alexsnarli/DigitalCamera/README.md

# DigitalCamera

Semester project in the subject TFE4152 - Design of Integrated Ciruits.

Design and simulation of a four pixel digital camera. Simulated analog circuit using AIM-Spice and the digital circuit using Verilog.

My partner and I scored top in our class on the report.
