alexsnarli/DigitalCamera/IC_Prosjekt.pdf

# Four Pixel Digital Camera

## TFE4152 – Design of Integrated Circuits

## Alexander Rambøl Snarli & Andrea Catharina Worsøe

Group 26

## November 18, 2019

## Faculty of Information Technology and Electrical Engineering Norwegian University of Science and Technology

Abstract

This design report describes the design of the integrated circuits needed for a four pixel digital camera. Both the digital and analog part of the circuit is described and simulated. The digital circuit is created using the hardware descriptive language Verilog, and simulated using the program Active-HDL. The analog part of the circuit it simulated using the program AIM-Spice. This report also describes the process of choosing the right dimensions for both NMOS and PMOS transistors using 180nm transistor technology, and choosing the right capacitors for the circuit. Both the digital and analog circuit has been tested in the simulations, to make sure the system behaves as intended. The simulations and tests shows that both the digital and analog circuits behave as inteded, and that the system operates as a four pixel digital camera successfully.

## Contents

1 Introduction | 3
2 Theoretical Background | 3
3 Design | 11
4 Simulations | 15
5 Results and Discussion | 23
6 Conclusion | 23

2

A Verilog Listing | 25
B AIM-Spice Listing | 31

## 1 Introduction

While film photography might be very trendy, digital cameras are far more common today. A regular cellphone camera has maybe 12 megapixels, and can be made very small. These are quite complex digital systems. They consist of millions of sensors, which are analog, that sample the light and store it digitally. To illustrate how this works one can design a smaller camera, in this case of four pixels.

Figure 1 shows a block diagram of a four pixel digital camera. Inside Readout and Control, there are three blocks. The block Pulse_shaper will not be discussed in this report. The other two blocks, RE_Control and Pixel_electronics, represent the digital and analog circuits respectively. This report describes both of these systems. The digital circuit receives input from the user, and send signals to the analog circuit based on the input. The analog part acts accordingly to the signals received from the digital circuit. The analog circuit output signals to an analog to digital converter, called an ADC. The ADC will not be discussed in this report. RE_Control will be simulated in Active-HDL, using the hardware descriptive language Verilog to build the circuit. Pixel_electronics represent the analog part of the circuit, and will be simulated using AIM-Spice. The analog part of the circuit is based on 180 nm CMOS technology, where transistors are used as switches and to create a buffer circuit. This report will also describe how to choose the right dimensions for the transistors and the capacitor in the analog circuit.

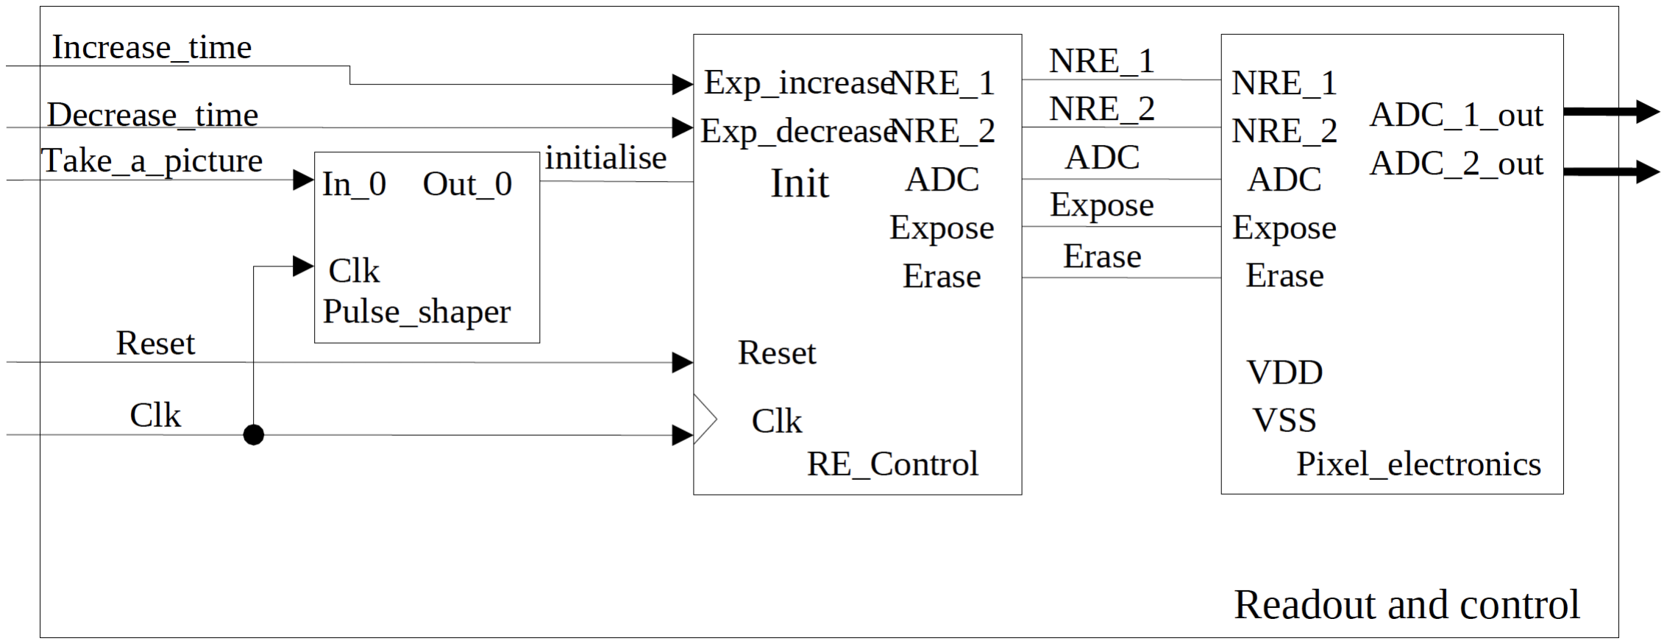
[picture p1: figure]

Figure 1: Block diagram of a four pixel digital camera. [1]

## 2 Theoretical Background

### 2.1 Digital Circuit Theory

The digital part of the circuit, RE_Control, receives input from the user, and control the analog circuit using these inputs. Figure 2 show the module for the digital circuit, with input signals on the left side and output signals on the right side of the module. init is the trigger signal, and is logically high when the user wants to take a photo. exp_inc and exp_dec will

3

be logically high, to increase and decrease the exposure time respectively, if the user wants to adjust the exposure time. Clk and Reset is controlled by control logic which will not be discussed in this paper. Reset will be logically high if the camera should be reset, and Clk is the clock signal for the circuit. The outputs NRE_1 and NRE_2 control which pixels should be read, while the ADC controls when the analog to digital converter should be initialized. Expose controls when the analog circuit should be exposed to light, and Erase erases the last exposure and resets the analog circuit.

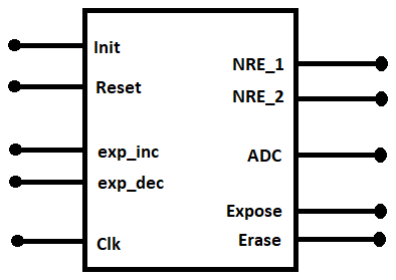
[picture p2: figure]

Figure 2: The digital circuit with inputs and outputs.

RE_Control, as seen in figure 3, consists of three modules called CTRL_ex_time, Timer_counter and FSM_ex_control. These are the exposure time controller, exposure time counter and finite state machine respectively.

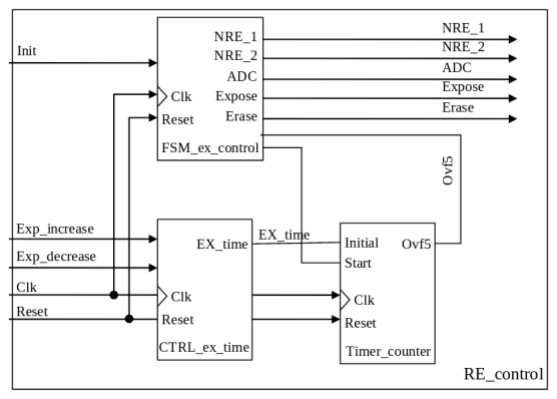
[picture p3: figure]

Figure 3: Block diagram of the digital circuit. [1]

4

### 2.1.1 Exposure Time Controller

The exposure time controller calculates the exposure time for the camera. The module has two user inputs, exp_inc and exp_dec. These inputs will increase or decrease the exposure time respectively. The user might want to adjust the exposure time based on the lighting conditions, which can affect the photographs quality. The exposure time is set to a base value, and increments or decrements a set value each time the user adjusts the exposure time. Exposure time also has an upper and a lower time boundary, and this module has to make sure exposure time stays within these boundaries. The exposure time controller sends the exposure time, EX_time, to the exposure time counter when the exposure time is calculated.

### 2.1.2 Exposure Time Counter

The exposure time counter controls the exposure time. The module receives the desired exposure time from the exposure time controller, and starts the counter when it receives the start signal, Start, from the finite state machine. When the exposure time is over, the overflow signal, Ovf5, will be sent back to the finite state machine.

### 2.1.3 Finite State Machine

The finite state machine is the most complex part of the digital circuit. A finite state machine, FSM, is a machine that has a set amount of states, which all have different characteristic values and functions. The FSM can only be in one of the states at any given time. The amount of states needed depends on the complexity of the system. The FSM will receive a trigger signal init which will start off the process of taking a picture. The start signal will be sent to the exposure timer counter, and it will receive the overflow signal when the exposure time is over. All the output signals from RE_Control to the analog circuit, are sent out through the finite state machine.

### 2.2 Analog Circuit Theory

The analog circuit is based on four identical circuits, which will output one pixel each. The circuit for each pixel is shown in figure 4.

5

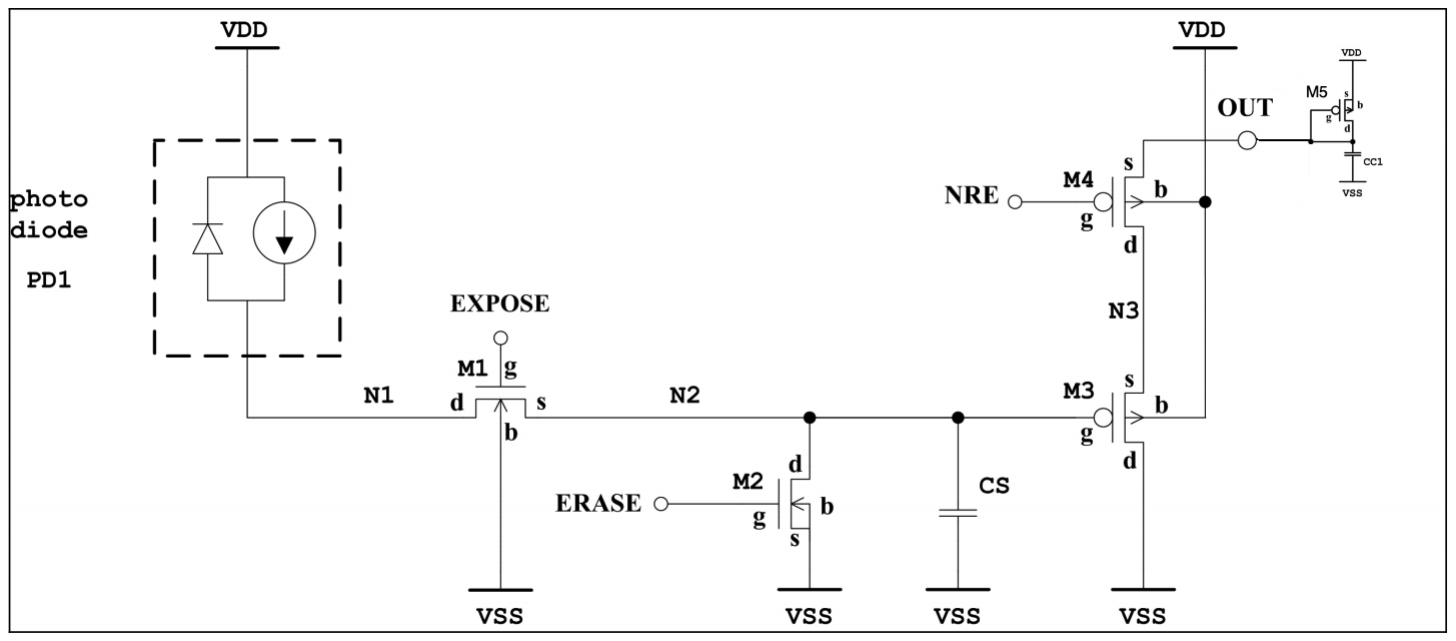
[picture p4: figure]

Figure 4: The analog circuit with the inputs Erase, Expose and NRE from the digital circuit. [1]

The circuit is based on a photo-diode, which will generate current. The generated current will depend on the lighting conditions, so that brighter conditions create a higher current and darker conditions create a lower current. This current is used to charge a capacitor, CS. Since we are charging a capacitor, we can achieve the same charge by exposing small current over a longer time interval, as exposing a higher current for a shorter time interval. Transistors M1 and M2 are NMOS transistors, and are controlled by logic signals from the digital circuit. While Expose is logic high, the capacitor CS is being charged. While Erase is logically high, we discharge the capacitor, and erase our last exposure so that we are ready to charge the capacitor again. In figure 4 you can also see the active load transistors MC1 and MC2 and its corresponding capacitors.

The circuit in figure 4 has nodes N1, N2 and N3 labeled. When the diode, P D1, is exposed to light and the Expose signal is set high the current IP D1 from the diode will continue to node N2. As long at the Erase signal is low, it will continue on to N3. The ADC can only read two pixels at a time, so the NRE signal decides whether the ADC is ready to read the signal or not. This is seen in figure 5.

The most important design decisions in this circuit are the dimensions of the transistors and the sizes of the capacitors. The design specifications are given in 3.2.

### 2.2.1 Choosing the Capacitors

The effective voltage of a transistor is given by equation (1).

Vef f = VGS − V t | (1)

Vef f should be above 100mV, and it is a good rule to keep it above 200 mV [3]. Since VGS = VG −VS this can be used to find the voltage over the capacitor, VS, as shown in section 3.2.

6

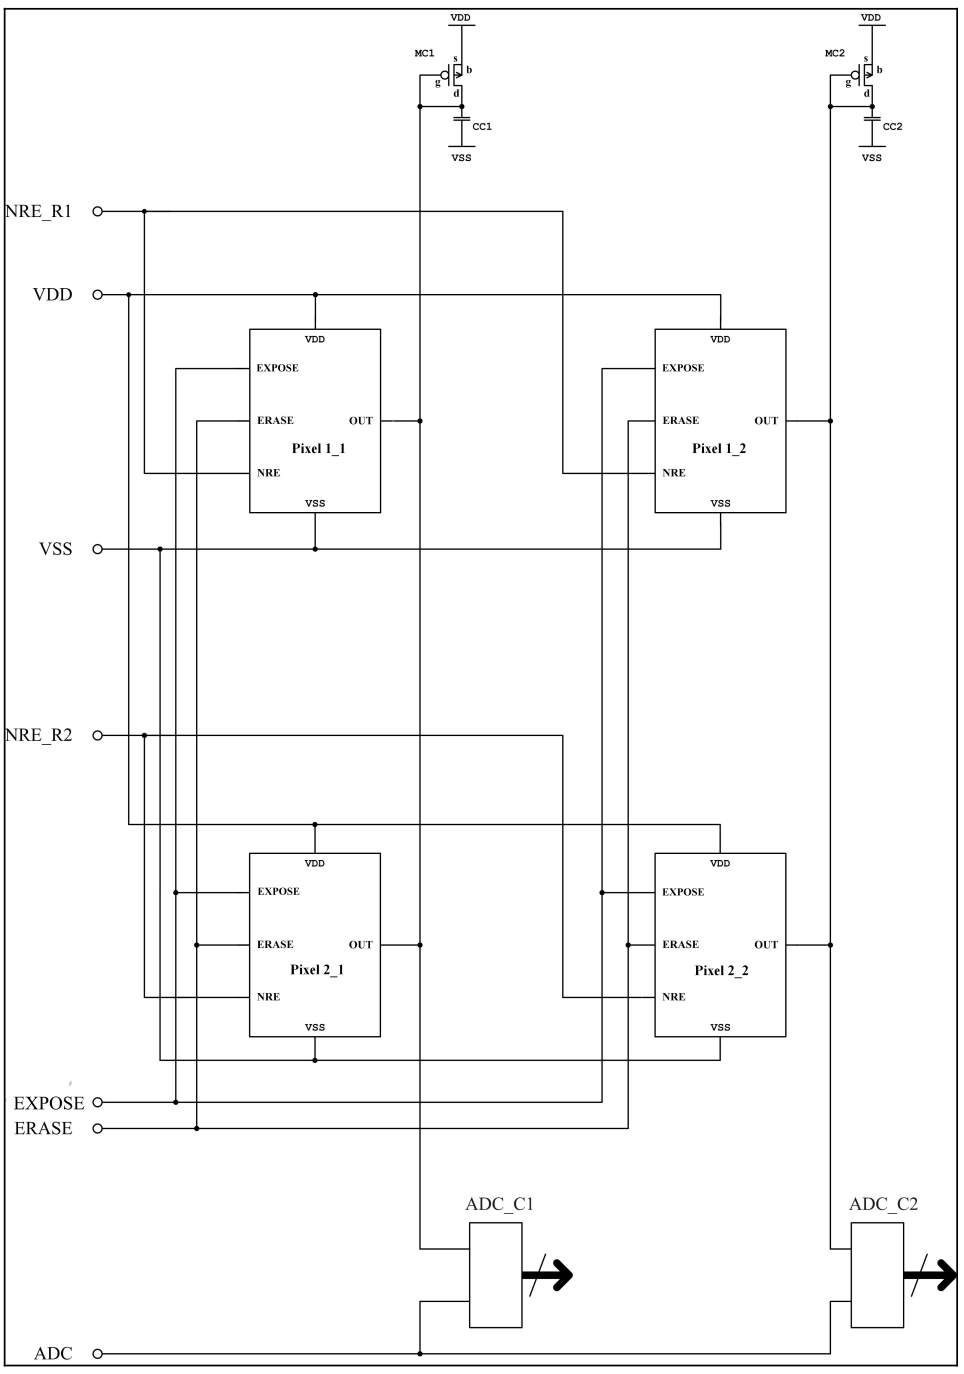
[picture p5: figure]

Figure 5: Four pixel array consisting of one pixel circuits, ADC_C1, ADC_C2 and active load transistor [1].

7

Due to the body-effect[3], which is caused by different voltages between source and bulk, we have to consider some more factors when doing calculations. For instance the voltage Vt is
given by equation (2).

Vt = Vt0 + γ(

q

VSB + |2ΦF | − q
|2ΦF |) | (2)

Equation (2) illustrates that the threshold voltage will be slightly higher with the body effect. The various components of this equations are given in equation (3) and equation (4).

ΦF =

kT
q

lnNA
ni

(3)

γ =

√
2qNAKSi0

Cox

(4)

The other are constants found in table 4 and 5. VSB is the voltage between source and bulk.

C =

It
V

(5)

The version of Ohm’s law, seen in equation (5), can be used to find the appropriate size for the capacitor Cs, using Vs as the voltage of the capacitor.

The other capacitors are given in the specifications, which can be found in section 3.2.

### 2.2.2 Choosing Dimensions for the Transistors

The equation for active region drain current is seen in equation (6) for NMOS and equation
(7) for PMOS [3].

ID =

1
2

µnCox

W
L

(Vtn − VGS)

2
[1 + λ(Vef f − VDS)] | (6)

ID =

1
2

µpCox

W
L

(VGS − Vtn)

2
[1 + λ(VDS − Vef f )] | (7)

The resistance between drain and source, rds can be related to to the drain current, ID, by
(8) [3].

rds ≈

1
λID

(8)

Here we use λ given by (9) for NMOS and (10) for PMOS [3]. Φ0 is the built in voltage of the junction.

8

λ =

1
L

p
VDS − Vef f + Φ0

(9)

λ =

1
L

p
Vef f − VDS + Φ0

(10)

Which again gives relation (11).

ID ∝

W
L

(11)

The transistors M1, M2 and M4 work as switches activated by specific signals from the digital circuit.

The buffer should be designed so that the gain is as close to 1 as possible. The important transistors here are M3 and MC. Here, the transistor MC is used as an active load. The transistor M4 is no concern, since it will work as a switch: either it has very low resistance, like a wire, or it has a very very high resistance, like an open circuit.

To find the gain, A, small signal analysis can be applied. The small signal model with body effect is shown in figure 6 [2].

To combine the current sources use that gm3Vsg +gm3Vbs = gm3(Vs −Vg +Vb −Vs) = gm3(Vb − Vg) = gm3Vbg. See also from the figure that by Kirchoff’s voltage law: Vbg = Vsg.

Vg

Vsg

Vs

Vout

gm3Vsg | gmbVbs

Vd

rds3

Vb

Vg

Figure 6: Small signal model for low frequencies. [2]

9

If one chooses to ignore the body effect, in the case that it is sufficiently small, this can be simplified. Figure 7 shows a simplified version of the model, along with the model for M5 simplified to a resistance. Because this is an active load common gate amplifier, we can simplify the impedance seen at Vout at low frequencies to ≈

1
gmC

[3, p. 126].

Vg

Vsg

Vs

Vout

gm3Vbg

VD

rds

1
gmC

Figure 7: Small signal model for M3 and MC with a combined current source.

Knowing that Vsg = Vbg, this is used in further calculations. The output is Vs and given by equation (12).

Vout = −Vsg(rds|| 1

gmC

) | (12)

Looking at the model, it also appears that Vg is the same as Vin. Vsg is given by equation (13).

Vsg = Vs − Vg = Vout − Vin | (13)

The resistance can be assumed to be rsd >> 1
gmC

[2], which allows for the equation (14).

Vout = −(Vout − Vin)gm3

1

gmc

(14)

The gain with simplifications is then given by equation (15).

10

A =

Vout

Vin

=

gm3

1
gmC
1 + gm3

1
gmC
=

gm3

gm3 + gmC

(15)

The value gm is given by equation (16) [3].

gm =

s
µCoxID

W
L

(16)

This formula is the same regardless of which gm one is looking at, and since all parameters are the same for both transistors the gain can be simplified, as shown in equation (17).

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
(17)

To achieve a gain as close as possible to 1, the transistor dimensions should be chosen accordingly.

## 3 Design

### 3.1 Digital Circuit Design

The digital circuit has been designed using Verilog and simulated in Active-HDL. The modules were created in separate Verilog modules, and put together in a separate module. All Verilog files can be found in Appendix A.

The specifications for this design is shown in table 1.

Specifications | Value
Clock speed (Clk) | 1kHz
Exposure time minimum (EX_time) | 2ms
Exposure time maximum (EX_time) | 30ms

Table 1: Specifications for the digital circuit.

11

### 3.1.1 Exposure Time Controller

The exposure time controller, CTRL_ex_time, controls the exposure time. The lower and upper boundaries for the exposure time is 2ms and 30ms respectively. The initial value of the exposure time is set in the middle of the boundaries, to 15ms. Every clock period the signal exp_inc or exp_dec is logically high, the exposure time is either incremented or decremented respectively, by 1ms. The exposure time controller also makes sure that the user cannot increase or decrease the exposure time outside of these boundaries. The exposure time, EX_time, is sent to the exposure time counter with a 5 bit signal. 5 bits is the least amount of bits to represent all the values within the boundaries. If the Reset signal is set logically high, the exposure time is set back it the initial value, 15ms.

### 3.1.2 Exposure Time Counter

The exposure time counter receives the 5 bit signal, EX_time, with the desired exposure time. When the Start signal is set logically high from the finite state machine, the counter begins. The time counter is designed to count down from the exposure time to zero. When the timer hits zero, it will set the overflow signal, Ovf5, high for one clock period, to the finite state machine.

### 3.1.3 Finite State Machine

The finite state machine is the most complex part of the digital circuit. This design has three states for the FSM. The three states are idle, Exposure and Readout. The idle state is the state the system is in when it is not in the process of taking a picture. In this state, the analog circuit is being reset, so that the system is ready to take a picture. The Exposure state is the state where the system is exposing the analog circuit, so that the pixels can be created. Table 2 shows the characteristic values for the states idle and Exposure.

Output | Idle | Exposure
NRE_1 | 1 | 1
NRE_2 | 1 | 1
ADC | 0 | 0
Expose | 0 | 1
Erase | 1 | 0

Table 2: Characteristic output values for the states idle and Exposure.

Readout is a much more complex state. This is the state where the readout from the analog circuit to the ADC happen. In this design, the Readout state is nine clock periods long, where one output changes each period. To accomplish this, the FSM has a timer which begins when the FSM enters the Readout state. Figure 8 shows a time chart of the desired signal outputs in the different states.

12

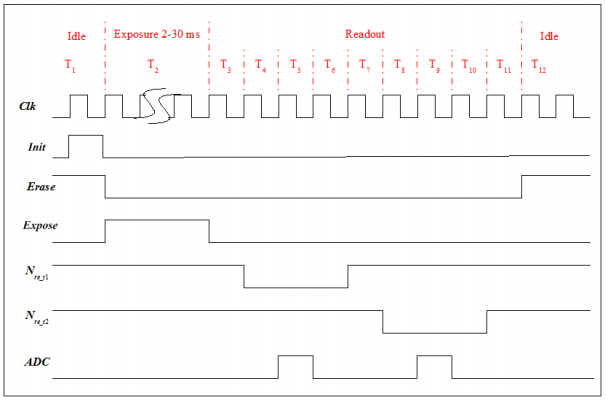
[picture p6: figure]

Figure 8: Desired time chart for the digital circuit. [1]

Figure 9 is a state diagram of the states in the finite state machine. The diagram shows what triggers the machine to change between states. When the system is in the idle state, the state can be changed to Exposure if init is set logically high while reset is not. While the system is in the Exposure state, the system will stay in this state until Ovf5 is set logically high. When Ovf5 is set logically high, the system changes state to the Readout state. The system will stay in the Readout until readout cycle is done. The diagram also shows that no matter what state the system is in, if Reset is set logically high, the system will change state back to idle.

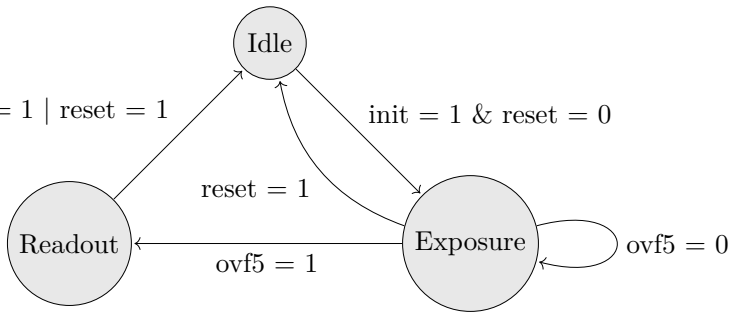
[picture p7: figure]
Idle; Readout; Exposure; ovf5 = 1; ovf5 = 0; reset = 1

readout_done = 1 | reset = 1 | init = 1 & reset = 0

Figure 9: State diagram for the FSM in the digital circuit.

### 3.2 Analog circuit

The analog circuit can be seen in figure 4. It is created using a photo diode, and depends on the signals Erase, Expose and NRE from the digital circuit. This will give an Out signal containing the current from the diode. The current from the diode is based on the amount of light and the exposure time from the Erase signal. The Out signal is then stored and used in the digital circuit shown in figure 1.

13

The specification and boundaries for the analog circuit components is shown in table 3. Table 4 shows the specifications for tranistors using 180nm technology.

Specifications | Value
Transistor length | 0.36µm < L < 1.080µm
Transistor width | 0.1080µm < W < 5.040µm
Cs | ≤ 3pF
CC1 = CC2 | 3pF
VDD | 1.8V
IP D1 | 50pA ≤ 750pA

Table 3: Specifications for the circuit [1].

Parameter | Value NMOS | Value PMOS
µCox | 270µA V ² | 70µA V ²
Vt0 | 0.45V | −0.45V
λL | 0.08µm V | 0.08µm V
Cox | fF 8.5 µV ² | fF 8.5 µV ²
tox | 5nm | 5nm
n | 1.6 | 1.7
θ | 1 1.7 V | 1 1.0 V
m | 1.6 | 2.4

Table 4: Parameters for 180 nm transistors [3].

Variable | Symbol | Value
Elementary charge | q | 1.602 · 10⁻¹⁹
Boltzmann constant | k | 1.38 · 10⁻²³JK⁻¹
Intrinsic carrier concentration | ni | 1.1 · 10¹⁶carriersm⁻³
Concentration of acceptor atoms | NA | Not given
Temperature (room temp.) | T | 300K
Electric constant | 0 | 8.854 · 10⁻¹²Fm⁻¹
Dielectric constant | Ksi | 11.8

Table 5: A collection of various constants needed for calculations.

### 3.2.1 The capacitor Cs

To complete the calculations, constants given in table 5 are useful. Without knowing the acceptor concentration, its hard to calculate the the body-effect constant exactly. However if NA is assumed to be in the order of 10¹⁶m⁻³
, which is a typical value, (4) can be used to calculate the body-effect constant to be γ ≈ 4.73 · 10⁻⁸
. This is very small, and the body effect can be assumed to be negligible.

14

As mentioned in section 2.2.1, Vef f was chosen to be 200mV , and assumed Vt0 ≈ Vt ≈ 0.45V . The upper case for for VG, when Expose is high, equals VDD = 1.8V . Using (1), this gives VS = 1.15V .

The minimal current, 50pA, is used for the maximum exposure time, which is 30ms and the maximum current, 750mA, is used for minimum exposure time which is 2ms.

This gives equation 18.

It = 50 · 10⁻¹²A · 30 · 10⁻³

s = 750 · 10⁻¹²A · 2 · 10⁻³

s = 1.5 · 10⁻¹²C | (18)

Equation (5) from section 2.2.1 is used to get Cs ≈ 1.3045 · 10⁻¹² . Cs = 1.3pF is chosen for this design.

### 3.2.2 Transistor dimensions

Since the transistors M1 and M4 are used as switches, minimizing the voltage drop over these is desired. This can be done by choosing wider and narrow as possible. From (8), rds is smallest for a high current, ID, which again allows us to use the relationship in (11). Using table 3, W1,4 = 5.040µm and L1,4 = 0.36µm can be chosen.

It is desired to minimize the leakage current over transistor M2. Equation (11), shows that it is desired to have a long and narrow transistor. Therefore W2 = L2 = 1.080µm are great values..

When choosing M3 and MC, equation (17) can be used. Because the body-effect is so small, figure 6 can be used, and the calculations are simplified. To make the gain as close to 1 as possible, dimensions W
L 5

should be as small as possible and W
L 3

should be as large as possible. Thus W3 = 5.04µm, L3 = 0.36µm, WC = 1.08µm and LC = 1.08µm are chosen. A collection of the transistor dimensions can be found in table 6.

— | Width | Length
M1 | 5.04µm | 0.36µm
M2 | 1.08µm | 1.08µm
M3 | 5.04µm | 0.36µm
M4 | 5.04µm | 0.36µm
MC | 1.08µm | 1.08µm

Table 6: Chosen transistor values

## 4 Simulations

Both the digital and analog circuit has been tested through simulations to check if they behave as planned. The digital circuit has been simulated in Active-HDL, while the analog circuit

15 has been simulated in AIM-Spice.

### 4.1 Simulations from Active-HDL

The circuit has been simulated using the hardware description language Verilog in the program Active-HDL. The code used to simulate the circuit can be found in appendix A. The system has been tested with different inputs to check the behaviour of the system. Figure 10 shows simple test of the whole system at the initial values. The test shows that the system starts off in idle, and goes through the whole cycle, from exposure to readout, then back to idle, when init is pressed.

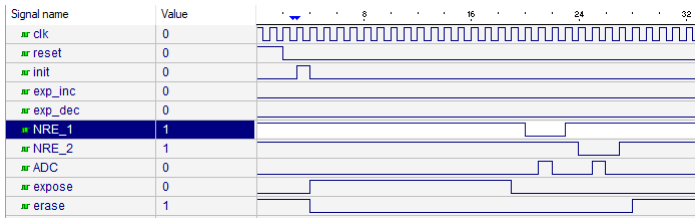
[picture p8: figure]

Figure 10: Test of one cycle. Going from idle to expose, then to readout, and back to idle.

Figure 11 shows a test of the lower boundary for the exposure time. Lower boundary is 2ms, so the system was tested for lowering the exposure time below this. The test shows that the exposure time is set to the lower boundary.

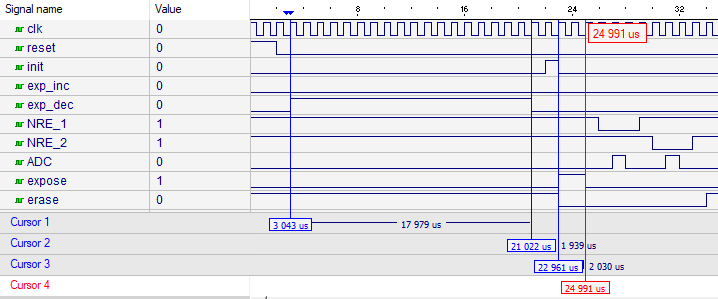
[picture p9: figure]

Figure 11: Test of the lower limit of exposure time. Here we try to decrease it to -2ms, but the exposure time is set to 2 as planned.

Figure 12 shows a test of the upper boundary for the exposure time. Upper boundary is 30ms, so the system was tested for increasing the exposure time over this limit. The test

16 shows that the exposure time is set to the upper boundary.

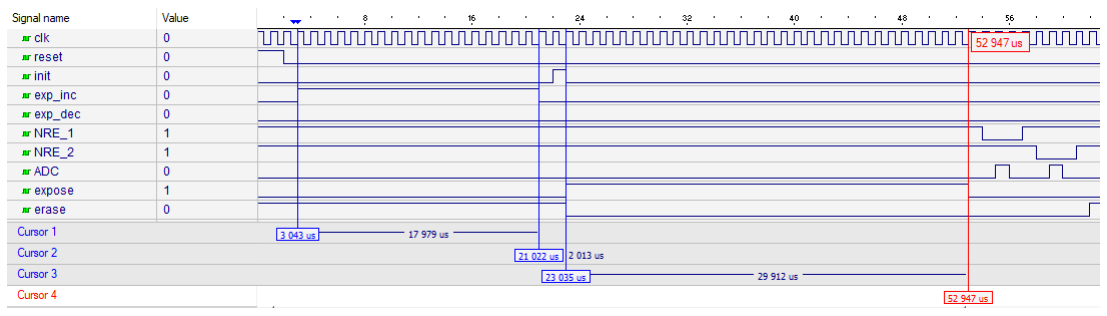
[picture p10: figure]

Figure 12: Test of the upper limit of exposure time. Here we try to increase it to 33ms, but the exposure time is set to 30 as planned.

Figure 13 shows a test of both exposure increase and decrease pressed at the same time. The test shows that the exposure time will not change when both are pressed at the same time.

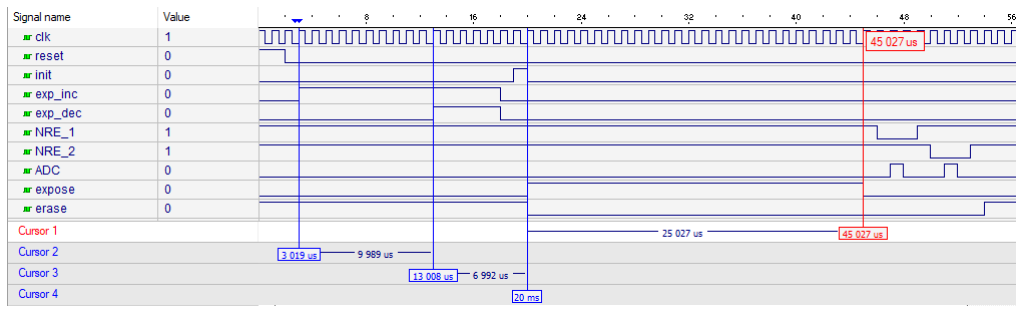
[picture p11: figure]

Figure 13: Test of both exposure increase and decrease pressed at the same time. The circuit behaves as planned, by not changing the exposure time when both are pressed at the same time.

Figure 14 shows a test of the reset button in the middle of the readout state. The cycle is stopped immediately, and all values are set back to idle mode.

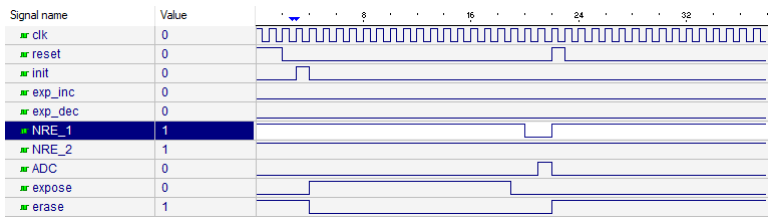
[picture p12: figure]

Figure 14: Test of the reset function, here shown in the middle of the readout state.

17

### 4.2 Simulations from AIM-Spice

The transistor and capacitor sizes were simulated in AIM Spice for both the highest possible diode current, 750 mA, and for the shortest, 50 mA. In figures 15, 21, 17, 18, and 19 all the different simulations are shown for the lowest current, 50 mA, combined with the longest possible exposure time.

The two out voltage’s, V(out1) and V(out2) are signals for ADC_C1 and ADC_C2. The two signals are pretty much identical, but we do two reading of two signals which again equals four pixels in total.

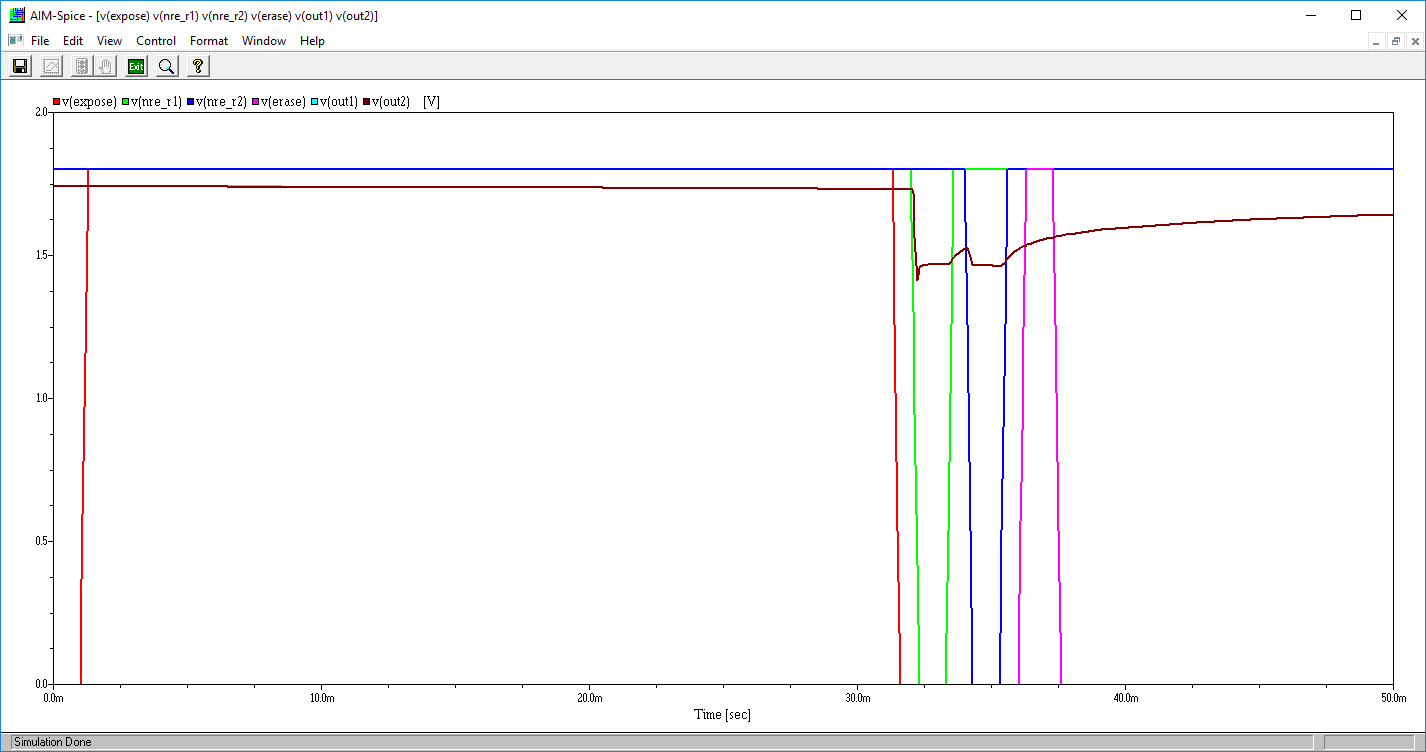
[picture p13: figure]

Figure 15: All logic values, V(out1) and V(out2) shown for 0.05s with 50mA from PD1.

18

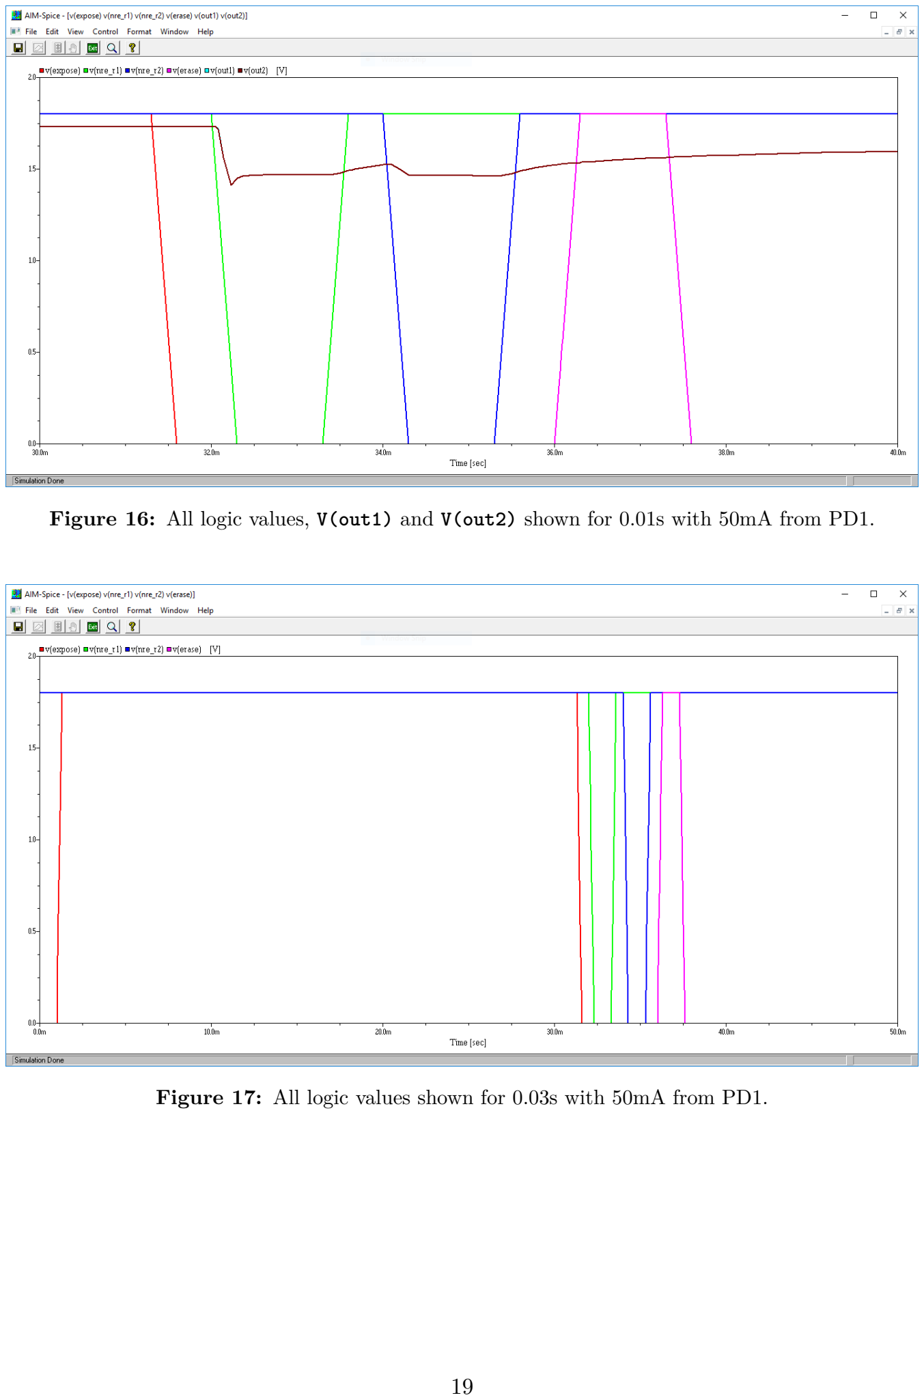
[picture p14: page 21]

Figure 16: All logic values, V(out1) and V(out2) shown for 0.01s with 50mA from PD1.

Figure 17: All logic values shown for 0.03s with 50mA from PD1.

19

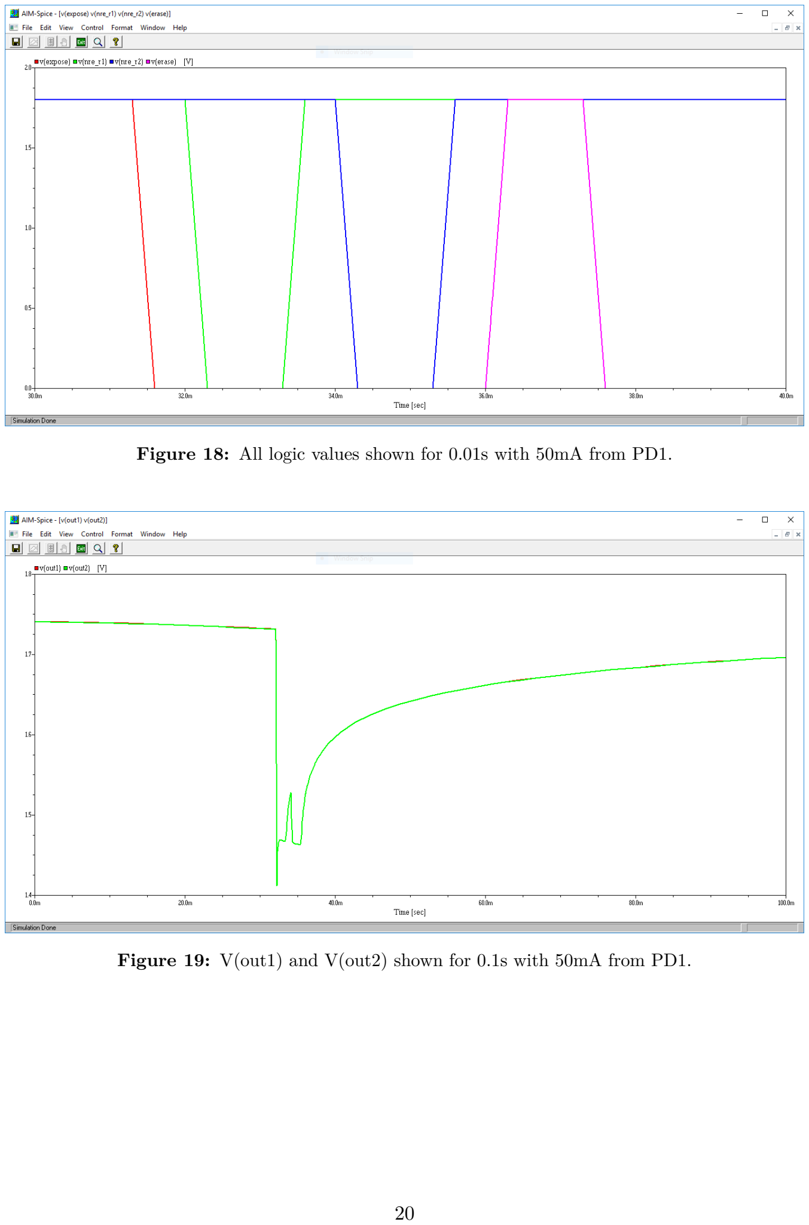
[picture p15: page 22]

Figure 18: All logic values shown for 0.01s with 50mA from PD1.

Figure 19: V(out1) and V(out2) shown for 0.1s with 50mA from PD1.

20

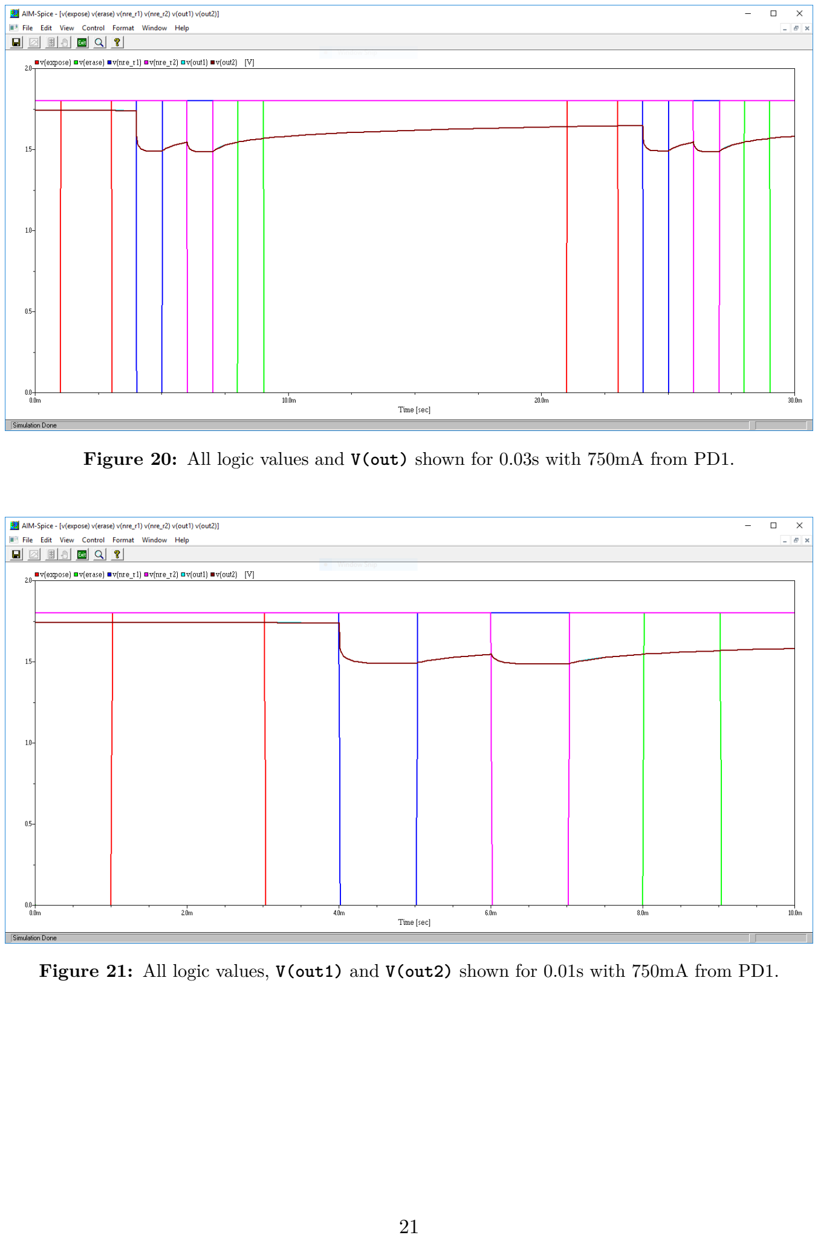
[picture p16: page 23]

Figure 20: All logic values and V(out) shown for 0.03s with 750mA from PD1.

Figure 21: All logic values, V(out1) and V(out2) shown for 0.01s with 750mA from PD1.

21

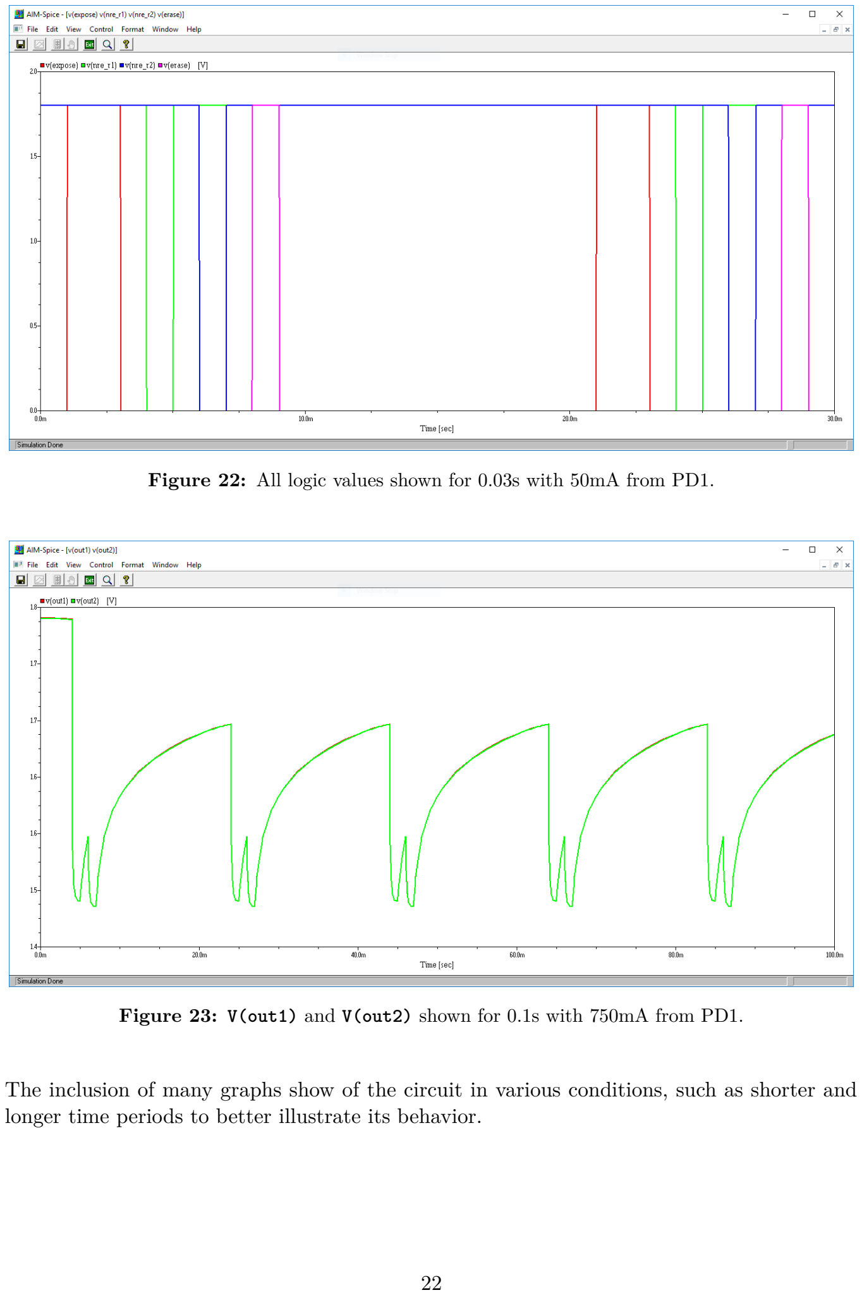
[picture p17: page 24]

Figure 22: All logic values shown for 0.03s with 50mA from PD1.

Figure 23: V(out1) and V(out2) shown for 0.1s with 750mA from PD1.

The inclusion of many graphs show of the circuit in various conditions, such as shorter and longer time periods to better illustrate its behavior.

22

## 5 Results and Discussion

### 5.1 Digital Circuit

The system has been designed and thoroughly tested. The test of both the lower and upper limits shows that the system will not set the exposure time lower or higher than the boundaries it is given. The tests also showed that if both exposure decrease and increase is pressed at the same time, the system behaves as it should and leaves the value as it is. The test of the reset function also behaves as planned. Reset cancels the cycle immediately, so that the system goes back to idle state.

The results from the simulations and testing of the digital system show that the circuit behaves as planned. The digital circuit therefore successfully acts as the digital component of a four pixel digital camera.

### 5.2 Analog Circuit

The analog circuit works with the digital circuit, and the figures 18, 17 an 22 are included to show the logic applied to the circuit during the simulation. This is a model for the behavior of the digital circuit. The analog circuit simulations show that the circuit works as it should. Since the circuit should be designed for different exposure times and diode currents the maximum and minimum values were tested. In figure 23 the voltage out stabilizes at a value slightly under 1.7 V between each picture. This indicates that the chosen, optimized with the specifications, values work for the purpose. Once the circuit enters exposure, the sequence will continue, thus we did not anticipate the need to test other signals than the ones tested.

## 6 Conclusion

This report has described how to create a four pixel camera. The report describes how to create a digital circuit, including using a finite state machine, to control an analog circuit. The digital circuit has been simulated using the hardware descriptive language Verilog in the program Active-HDL. The simulations show that the digital circuit behaves as expected. The boundaries of the digital circuit has been tested by trying to exceed the limits of exposure time, in figures 12 and 11 where it was shown that the system is capable of keeping its variables within the given boundaries. A test of trying to increase and decrease the exposure time at the same time was also done, figure 13, to show that the system could handle it. The system was also tested with a reset in the middle of the cycle, figure 14, where it proved to be able to cancel a picture, and return to its idle state.

This report has also described how to create the analog circuit for a pixel camera. Choosing transistor dimensions and capacitor size is an important part of this circuit, and this has been thoroughly described. Simulations has been done in AIM-Spice to show how the system works, based on the input from the digital system. Simulations are useful, because it is easy

23 to see how the circuit will behave over long and short periods of time. In the simulation upper and lower boundaries were tested, which showed that the circuit worked for both cases. It also showed that although there were some attenuation of the signal initially, it stabilized quickly and would be predictable for the digital designer to work with.

The successful simulations and tests conclude that this report successfully describes the analog and digital circuits needed to create a simple four pixel digital camera.

## References

[1] Bjørn B. Larsen. Project Description – Digital Cameera. 2019.
[2] Microelectronic Devices and Circuits. url: https://inst.eecs.berkeley.edu/~ee105/fa14/lectures/Lecture13-Small%20Signal%20Model-MOSFET.pdf. (https://inst.eecs.berkeley.edu/~ee105/fa14/lectures/Lecture13-Small%20Signal%20Model-MOSFET.pdf)
[3] Kenneth W. Martin Tony Chan Carusone David A. Johns. Analog Integrated Circuit Design. 2nd ed. John Wiley & Sons, Inc, 2012.

24

## A Verilog Listing

Listing 1: Verilog code for module Timer_counter ‘ t i m e s c a l e 1 ms / 1 us // make sure the same timescale is used in the whole system

3 module Timer_counter ( i n p u t wi r e cl k , r e s e t , s t a r t , i n p u t r e g [ 4 : 0 ] ex_time , output r e g o v f 5 ) ;
4 | r e g | [ 4 : 0 ] time r ; | // timer for exposure time
r e g keep_counting ; // to check if we are in the expose time always @( p o sed ge cl k ) b e gi n
// reset everything
i f ( r e s e t ) b e gi n
| | tim e r <= 0 ; o v f 5 <= 0 ;

keep_counting = 0 ;
| | end // if reset

// start will set the timer and that we are in the expose
| | time
e l s e i f ( s t a r t ) b e gi n
tim e r <= ex_time − 1 ; // set timer to expose time , and subtract one because one cycle has already been done when this is started
keep_counting <= 1 ; // we are in the expose time
| | end // if start

// count down if we are not finished exposing and still in exposure time
e l s e i f ( time r != 0 && keep_counting ) tim e r <= time r − 1 ;

// if we are in the exposed time and want to end it
e l s e i f ( tim e r == 0 && keep_counting ) b e gi n
o v f 5 <= 1 ; // sent the signal that we are done exposing keep_counting <= 0 ; // we are no longer in expose time
| | end // if timer
end // always
29 endmodule // Timer_counter

25

Listing 2: Verilog code for module CTRL_ex_time ‘ t i m e s c a l e 1 ms / 1 us // make sure the same timescale is used in the whole system

3 module CTRL_ex_time ( i n p u t wi r e exp_inc , exp_dec , cl k , r e s e t , output r e g [ 4 : 0 ] ex_time ) ;
always @( p o sed ge cl k ) b e gi n
// set the standard exposure time to 15ms
i f ( r e s e t ) ex_time <= 1 5;

// if both buttons are pressed , the exposure time remains unchanged
i f ( exp_inc && exp_dec ) ex_time <= ex_time ;

// increase by 1ms if exp_inc is pressed and we are under our maximum exposure time of 30ms
e l s e i f ( exp_inc & ex_time <30) ex_time <= ex_time+1;

// decrease by 1ms if exp_dec is pressed and we are over our minimum exposure time of 2ms
e l s e i f ( exp_dec & ex_time>2) ex_time <= ex_time −1;

end // always
18 endmodule // CTRL_ex_time

26

Listing 3: Verilog code for module FSM_ex_control

‘ t i m e s c a l e 1ms / 1us // make sure the same timescale is used in the whole system

4 module FSM_ex_control( i n p u t r e g i n i t , cl k , r e s e t , ov f5 , output r e g NRE_1, NRE_2, ADC, expose , e r a s e , s t a r t ) ;
parameter [ 1 : 0 ] i d l e = 2 ’ b00 ;
parameter [ 1 : 0 ] e xp o su re = 2 ’ b01 ;
parameter [ 1 : 0 ] re ad ou t = 2 ’ b10 ;

r e g [ 1 : 0 ] s t a t e , ne x t_ s t a te ; // used to change states r e g [ 4 : 0 ] read_coun te r ; // counter for readout state

// clock signal
always @( p o sed ge cl k ) b e gi n

// reset should change state to idle
i f ( r e s e t ) b e gi n
s t a t e <= i d l e ; // change state to idle
read_coun te r <= 0 ; // reset counter for readout state end // if reset

// change state
e l s e s t a t e <= n e x t_ s t a t e ;

// count up while in the readout state
i f ( s t a t e == re ad ou t ) read_coun te r <= read_coun te r + 1 ; end // always clk

// Finite state machine
29 | always @ ( ∗ ) | b e gi n
case ( s t a t e )
// idle state
i d l e : b e gi n
| | // set characteristic values for this state e r a s e <= 1 ; exp o se <= 0 ; NRE_1 <= 1 ; NRE_2 <= 1 ; ADC <= 0 ; s t a r t <= 0 ;
| | // init begins the expose -readout cycle i f ( i n i t ) b e gi n

27

// set next state and initial values for nextstate
n e x t_ s t a te <= e xp o su re ;
s t a r t <= 1 ;
exp o se <= 0 ;
e r a s e <= 1 ;
end // if init
// if nothing is pressed , stay in idle
e l s e n e x t_ s t a t e <= s t a t e ; end // idle state

//exposure state
e xp o su re : b e gi n
// characteristic values for exposure state e r a s e <= 0 ;
s t a r t <= 0 ;
exp o se <= 1 ;

// overflow signal (ovf5) signals that exposure time is done
i f ( o v f 5 ) b e gi n
62 | n e x t_ s t a te <= re ad ou t ; | // change state to
| readout
exp o se <= 0 ; // turn off exposure
| end // if ovf5

// stay in exposure if ovf5 signal is not recieved
| e l s e n e x t_ s t a t e <= e xp o su re ; end // exposure state
| // readout state re ad ou t : b e gi n

// read_counter is started and changes the values
| for each clock cycle
i f ( read_coun te r == 0 ) NRE_1 <= 0 ;
i f ( read_coun te r == 1 ) ADC <= 1 ;
i f ( read_coun te r == 2 ) ADC <= 0 ; i f ( read_coun te r == 3 ) NRE_1 <= 1 ; i f ( read_coun te r == 4 ) NRE_2 <= 0 ; i f ( read_coun te r == 5 ) ADC <= 1 ; i f ( read_coun te r == 6 ) ADC <= 0 ; i f ( read_coun te r == 7 ) NRE_2 <= 1 ;
| // cycle completed i f ( read_coun te r == 8 ) b e gi n

n e x t_ s t a te <= i d l e ; // go back to idle

| 28

85 | e r a s e <= 1 ; // erase right away , so the system
| is ready for another picture
86 | end // if read_counter
87 | end // readout state
88 | endc a se // FSM cases
89 | end // always FSM
90 endmodule //FSM_ex_control

29

Listing 4: Verilog code for module RE_control 1 ‘ t i m e s c a l e 1 ms / 1 us // make sure the same timescale is used in the whole system
2
3 module RE_control ( i n p u t r e g i n i t , exp_inc , exp_dec , cl k , r e s e t , output r e g NRE_1 , NRE_2 , ADC , exp o se , e r a s e ) ;
4 | r e g o v f 5 , s t a r t ; // overflow and start signal
5 | r e g [ 4 : 0 ] ex_time ; | // exposure time
6
7 | // Exposure time controller
8 | CTRL_ex_time Ctrl_ex ( exp_inc , exp_dec , cl k , r e s e t , ex_time
) ;
9
10 | // Exposure time counter
11 | Timer_counter Timer ( cl k , r e s e t , s t a r t , ex_time , o v f 5 ) ;
12
13 | // Finite state machine
14 | FSM_ex_control FSM ( i n i t , cl k , r e s e t , ov f5 , NRE_1 , NRE_2,
ADC, exp o se , e r a s e , s t a r t ) ; 15 endmodule // RE_control

30

## B AIM-Spice Listing

Listing 5: Code used for simulations in AIM-Spice

1 Analog Circuit
2
3 | ! ------------ Sizes of transistors and capacitors - - - - - - - - - - - -
4 | . param Wmax ={5.04 u}
5 | . param Lmax ={1.08 u}
6 | . param Wmin ={1.08 u}
7 | . param Lmin ={0.36 u}
8 | . param Cs ={1.3 p}
9
10
11 | . param VDD = 1.8 ! Supply voltage
12 | . param Ipd_1 = 50p ! Photodiode current , range [50 pA , 750 pA]
13 | . param EXPOSURETIME = 30m ! Exposure time , range [2 ms , 30 ms]
14 | . param TRF = { EXPOSURETIME /100} ! Risetime and falltime of EXPOSURE and ERASE
signals
15 | . param PW = { EXPOSURETIME } ! Pulsewidth of EXPOSURE and ERASE signals
16 | . param PERIOD = { EXPOSURETIME *10} ! Period for testbench sources
17 | . param FS = 1k; ! Sampling clock frequency
18 | . param CLK_PERIOD = {1/ FS} ! Sampling clock period
19 | . param EXPOSE_DLY = { CLK_PERIOD } ! Delay for EXPOSE signal
20 | . param NRE_R1_DLY = {2* CLK_PERIOD + EXPOSURETIME } ! Delay for NRE_R1 signal
21 | . param NRE_R2_DLY = {4* CLK_PERIOD + EXPOSURETIME } ! Delay for NRE_R2 signal
22 | . param ERASE_DLY = {6* CLK_PERIOD + EXPOSURETIME } ! Delay for ERASE signal
23
24 VDD VDD 0 dc VDD
25
26
27 | VEXPOSE EXPOSE 0 dc 0 pulse (0 VDD EXPOSE_DLY TRF TRF EXPOSURETIME PERIOD )
28 | VERASE ERASE 0 dc 0 pulse (0 VDD ERASE_DLY TRF TRF CLK_PERIOD PERIOD )
29 | VNRE_R1 NRE_R1 0 dc 0 pulse (VDD 0 NRE_R1_DLY TRF TRF CLK_PERIOD PERIOD )
30 | VNRE_R2 NRE_R2 0 dc 0 | pulse (VDD 0 NRE_R2_DLY TRF TRF CLK_PERIOD PERIOD )
31
32
33 | XPIXEL11 VDD EXPOSE ERASE NRE_R1 OUT1 PIXEL
34 | XPIXEL12 VDD EXPOSE ERASE NRE_R1 OUT2 PIXEL
35 | XPIXEL21 VDD EXPOSE ERASE NRE_R2 OUT1 PIXEL
36 | XPIXEL22 VDD EXPOSE ERASE NRE_R2 OUT2 PIXEL
37 | XBUFFER1 OUT1 VDD BUFFER
38 | XBUFFER2 OUT2 VDD BUFFER
39
40
41 | . plot V( OUT1 ) V( OUT2 )
42 | . plot V( EXPOSE ) V( NRE_R1 ) V( NRE_R2 ) V( ERASE )
43 | . plot V( EXPOSE ) V( NRE_R1 ) V( NRE_R2 ) V( ERASE ) V( OUT1 ) V( OUT2 )
44
45
46 | ! --------------- Photodiode
47 | . subckt PhotoDiode VDD N1_R1C1
48 | I1_R1C1 | VDD | N1_R1C1 | DC | Ipd_1
49 | d1 N1_R1C1 vdd dwell 1
50 | . model dwell d cj0 =1e -14 is =1e -12 m =0.5 bv =40
51 | Cd1 N1_R1C1 VDD 30f

31

52 . ends
53
54 | ! ---------------One pixel circuit
55 | . subckt PIXEL VDD EXPOSE ERASE NRE OUT
56 | XPD1 VDD N1 PhotoDiode
57 | MN1 N1 EXPOSE N2 0 NMOS W= Wmax L= Lmin
58 | MN2 N2 ERASE 0 0 NMOS W= Wmin L= Lmax
59 | CS N2 0 Cs
60 | MP3 0 N2 N3 VDD PMOS W= Wmax L= Lmin
61 | MP4 N3 NRE OUT VDD PMOS W= Wmin L= Lmax
62 | . ends
63
64 | ! --------------- Buffer
65 | . subckt BUFFER OUT VDD
66 | MC1 OUT OUT VDD VDD PMOS W= Wmin L= Lmax
67 | CC1 OUT 0 3p
68 | . ends
69
70 | . include p18_cmos_models .inc
71 | . include p18_model_card .inc

32
